cerocca/AirSpark/README.md

# AirSpark
Spark core powered Weather & Air Monitoring Device

Weather sensors:
- DHT22
- BMP180
- RJ sockets for external rain and wind meters

Air quality sensors:
- MICS-4514
- TGS-2xxx socket (fits TGS-2600, TGS-2602, etc)
- MQ-x socket (fits MQ-3, MQ-5, etc)
