cerocca/AirSpark/AirSpark_0.9-BOM.xls

Qty | Value | Device | Parts | Description | Comments | SMD/TH | Pins n° | Tot pins | Supplier | Supplier P/N | Manufacturer | Manufacturer P/N | Cost 1 (€) | Cost 100 (€)
 | SMD
1 | 100n | C-USC0603 | C1 | MLCC SMD capacitor, X7R, 100NF +/- 10% , 25V | min order qty. 10 pcs | SMD | 2 | 2 | farnell | 1759037 (http://it.farnell.com/multicomp/mc0603b104k250ct/condensatore-mlcc-x7r-100nf-25v/dp/1759037) | Multicomp | MC0603B104K250CT (http://it.farnell.com/multicomp/mc0603b104k250ct/condensatore-mlcc-x7r-100nf-25v/dp/1759037) | 0.0073 | 0.062
1 | 10uF | C-USC0603 | C2 | MLCC SMD capacitor, X5R, 10uF +/- 10%, 10V | min order qty. 10 pcs | SMD | 2 | 2 | farnell | 2211164 (http://it.farnell.com/tdk/c1608x5r1a106k080ac/condensatore-mlcc-x5r-10uf-10v/dp/2211164) | TDK | C1608X5R1A106K080AC (http://it.farnell.com/tdk/c1608x5r1a106k080ac/condensatore-mlcc-x5r-10uf-10v/dp/2211164) | 0.24 | 0.133
 |  |  |  |  | alternative part |  |  |  |  | 1288201 (http://it.farnell.com/kemet/c0603c106m9pactu/condensatore-mlcc-x5r-10uf-6-3v/dp/1288201) |  | C0603C106M9PACTU (http://it.farnell.com/kemet/c0603c106m9pactu/condensatore-mlcc-x5r-10uf-6-3v/dp/1288201)
7 | 1k | R-US_R0603 | R1, R5 .. R10 | Thick film SMD resistor, 1K, 0.5%, 50V, 100mW | min order qty. 10 pcs | SMD | 2 | 14 | farnell | 2379938 (http://it.farnell.com/panasonic-electronic-components/erj3rbd1001v/res-thick-film-1k-0-5-50v-0603/dp/2379938) | Panasonic | ERJ3RBD1001V (http://it.farnell.com/panasonic-electronic-components/erj3rbd1001v/res-thick-film-1k-0-5-50v-0603/dp/2379938) | 0.032 | 0.039
 |  |  |  |  | alternative part |  |  |  |  | 2303145 (http://it.farnell.com/panasonic-electronic-components/erj3ekf1001v/res-thick-film-1k-100mw-1-0603/dp/2303145) |  | ERJ3EKF1001V (http://it.farnell.com/panasonic-electronic-components/erj3ekf1001v/res-thick-film-1k-100mw-1-0603/dp/2303145)
5 | 10k | R-US_R0603 | R2, R13, R14, R16, R18 | Thick film SMD resistor, 10K, 0.5%, 50V, 100mW | min order qty. 10 pcs - R14 biases TGS-2600 | SMD | 2 | 10 | farnell | 2303192 (http://it.farnell.com/panasonic-electronic-components/erj3ekf1002v/res-thick-film-10k-100mw-1-0603/dp/2303192) | Panasonic | ERJ3EKF1002V (http://it.farnell.com/panasonic-electronic-components/erj3ekf1002v/res-thick-film-10k-100mw-1-0603/dp/2303192) | 0.008 | 0.0074
2 | 4.7k | R-US_R0603 | R3, R4 | Thick film SMD resistor, 4.7K, 0.5%, 50V, 100mW | min order qty. 10 pcs | SMD | 2 | 4 | farnell | 2303181 (http://it.farnell.com/panasonic-electronic-components/erj3ekf4701v/res-thick-film-4k7-100mw-1-0603/dp/2303181) | Panasonic | ERJ3EKF4701V (http://it.farnell.com/panasonic-electronic-components/erj3ekf4701v/res-thick-film-4k7-100mw-1-0603/dp/2303181) | 0.011 | 0.008
1 | 1M | R-US_R0603 | R11 | Thick film SMD resistor, 1M, 0.5%, 50V, 100mW | min order qty. 10 pcs - biases MQ sensor | SMD | 2 | 2 | farnell | 2303325 (http://it.farnell.com/panasonic-electronic-components/erj3ekf1004v/res-thick-film-1m-100mw-1-0603/dp/2303325) | Panasonic | ERJ3EKF1004V (http://it.farnell.com/panasonic-electronic-components/erj3ekf1004v/res-thick-film-1m-100mw-1-0603/dp/2303325) | 0.009 | 0.0079
3 | 100R | R-US_R0603 | R12, R15, R17 | Thick film SMD resistor, 100R, 0.5%, 50V, 100mW | min order qty. 10 pcs | SMD | 2 | 6 | farnell | 2303059 (http://it.farnell.com/panasonic-electronic-components/erj3ekf1000v/res-thick-film-100r-100mw-1-0603/dp/2303059) | Panasonic | ERJ3EKF1000V (http://it.farnell.com/panasonic-electronic-components/erj3ekf1000v/res-thick-film-100r-100mw-1-0603/dp/2303059) | 0.008 | 0.0074
2 | 82R | R-US_R0603 | R19, R22 | Thick film SMD resistor, 82R, 0.5%, 50V, 100mW | min order qty. 10 pcs | SMD | 2 | 4 | farnell | 2303052 (http://it.farnell.com/panasonic-electronic-components/erj3ekf82r0v/res-thick-film-82r-100mw-1-0603/dp/2303052) | Panasonic | ERJ3EKF82R0V (http://it.farnell.com/panasonic-electronic-components/erj3ekf82r0v/res-thick-film-82r-100mw-1-0603/dp/2303052) | 0.008 | 0.0057
1 | 51R | R-US_R0603 | R20 | Thick film SMD resistor, 51R, 0.5%, 50V, 100mW | min order qty. 10 pcs | SMD | 2 | 2 | farnell | 2059275 (http://it.farnell.com/panasonic-electronic-components/erj3ekf51r0v/resistore-0603-51r-1-0-1w/dp/2059275) | Panasonic | ERJ3EKF51R0V (http://it.farnell.com/panasonic-electronic-components/erj3ekf51r0v/resistore-0603-51r-1-0-1w/dp/2059275) | 0.009 | 0.008
1 | 1.4k | R-US_R0603 | R21 | Thick film SMD resistor, 1.4K, 0.5%, 50V, 100mW | min order qty. 10 pcs - biases MICS-4514 | SMD | 2 | 2 | farnell | 2311968 (http://it.farnell.com/panasonic-electronic-components/erjp03f1401v/resistore-pell-spessa-1-4kohm/dp/2311968) | Panasonic | ERJP03F1401V (http://it.farnell.com/panasonic-electronic-components/erjp03f1401v/resistore-pell-spessa-1-4kohm/dp/2311968) | 0.0871 | 0.0618
1 | 47k | R-US_R0603 | R23 | Thick film SMD resistor, 47K, 0.5%, 50V, 100mW | min order qty. 10 pcs | SMD | 2 | 2 | farnell | 2303213 (http://it.farnell.com/panasonic-electronic-components/erj3ekf4702v/res-thick-film-47k-100mw-1-0603/dp/2303213) | Panasonic | ERJ3EKF4702V (http://it.farnell.com/panasonic-electronic-components/erj3ekf4702v/res-thick-film-47k-100mw-1-0603/dp/2303213) | 0.009 | 0.0079
6 | BAS16 | DIODE | D1 .. D6 | SOD-323 signal diode | min order qty. 5 pcs | SMD | 2 | 12 | farnell | 1459029 (http://it.farnell.com/on-semiconductor/bas16ht1g/diodo-segnale-75v-sod-323/dp/1459029) | ON Semi | BAS16HT1G (http://it.farnell.com/on-semiconductor/bas16ht1g/diodo-segnale-75v-sod-323/dp/1459029) | 0.169 | 0.058
3 | NMOS BSS138 | N-MOS | Q1, Q2, Q3 | 60 V, 360 mA N-channel Trench MOSFET | min order qty. 5 pcs | SMD | 3 | 9 | farnell | 1859849 (http://it.farnell.com/nxp/bss138p/mosfet-canale-n-60v-0-36a-sot23/dp/1859849) | NXP | BSS138P (http://it.farnell.com/nxp/bss138p/mosfet-canale-n-60v-0-36a-sot23/dp/1859849) | 0.129 | 0.069
1 | MICS-4514 | MICS-4514 | U$6 | CO & NOx sensor | price in USD, needs RFQ x > 100 pcs | SMD | 10 | 10 | cdiweb | MICS-4514 (http://www.cdiweb.com/ProductDetail/MICS4514-e2v/333417/) | SGX Sensortech Ltd. | MICS-4514 (http://www.cdiweb.com/ProductDetail/MICS4514-e2v/333417/) | 9.72 | 6.2
 | TH_2_SOLDER
1 | 5V PWR | LED3MM | LED1 | LED | can be omitted | TH | 2 | 2 | farnell | N/A | various | N/A | 0.1 | 0.1
1 | 0.5M | TRIM_US-B25P | POT1 | 1/4 ” Square 3 pole Trimming Potentiometer | flat angled - biases MQ sensor | TH | 3 | 3 | farnell | 9354395 (http://it.farnell.com/bourns/3362p-1-504lf/taglierina-500k/dp/9354395) | BOURNS | 3362P-1-504LF (http://it.farnell.com/bourns/3362p-1-504lf/taglierina-500k/dp/9354395) | 0.816 | 0.583
1 | 5k | TRIM_US-B25P | POT2 | 1/4 ” Square 3 pole Trimming Potentiometer | flat angled - biases TGS-2600 | TH | 3 | 3 | farnell | 9354379 (http://it.farnell.com/bourns/3362p-1-502lf/trimmer-5k/dp/9354379) | BOURNS | 3362P-1-502LF (http://it.farnell.com/bourns/3362p-1-502lf/trimmer-5k/dp/9354379) | 0.996 | 0.596
1 | CALIBRATION | TAC_SWITCHPTH | S1 | Momentary Switch | calibration push button | TH | 4 | 4 | various | N/A | various | N/A | 0.1 | 0.1
2 | SPARK_CORECORE | SPARK_CORECORE | U$1 | Spark Core microcontroller sockets | 2x12 pin female sockets | TH | 12 | 24 | farnell | 1593465 (http://it.farnell.com/multicomp/2212s-12sg-85/socket-pcb-1-fila-12-vie/dp/1593465) | Multicomp | 2212S-12SG-85 (http://it.farnell.com/multicomp/2212s-12sg-85/socket-pcb-1-fila-12-vie/dp/1593465) | 0.121 | 0.112
1 | BMP_BRK | BMP_BRK | U$2 | BMP180 sensor breakout socket | can be omitted - 1x5 pin female socket | TH | 5 | 5 | farnell | 1593461 (http://it.farnell.com/multicomp/2212s-05sg-85/socket-pcb-1-fila-5-vie/dp/1593461) | Multicomp | 2212S-05SG-85 (http://it.farnell.com/multicomp/2212s-05sg-85/socket-pcb-1-fila-5-vie/dp/1593461) | 0.674 | 0.538
1 | DHT22 | DHT22 | U$3 | DHT22 sensor | Humidity & Temperature sensor | TH | 4 | 4 | ebay | DHT22 / AM2302 | various | DHT22 / AM2302 | 5 | 4
1 | MQ_SENSOR_SOCKET | MQ_SENSOR_SOCKET | U$4 | MQ sensor socket | any 6 pin MQ sensor should fit | TH | 7 | 7 | various | N/A | N/A | N/A | 1 | 0.5
1 | TGS_SENSOR_SOCKET | TGS_SENSOR_SOCKET | U$5 | TGS sensor socket | TGS-2xxx sensors should fit | TH | 4 | 4 | Figaro | SR-6 | Figaro | SR-6 | 3.7 | 3
3 | I2C, ADC, UART | TWIG-4P-2.0-2.0 | J1, J2,J3 | GROVE style male 4 pin PCB connector | price in USD, min order qty. 10 pcs | TH | 4 | 12 | seeedstudio | SKU: ACC39145O | N/A | N/A | 0.9 | 0.9
1 | USB-SMD-NS | USB-SMD-NS | X1 | Mini-B USB connector | used for power only (5V) | TH | 11 | 11 | farnell | 1654060 (http://it.farnell.com/te-connectivity-amp/1734035-1/connettore-mini-usb-b-contatto/dp/1654060) | TE conn./ AMP | 1734035-1. (http://it.farnell.com/te-connectivity-amp/1734035-1/connettore-mini-usb-b-contatto/dp/1654060) | 1.2 | 0.904
1 | VIN_SCREW | 1751248 | X2 | 3,5 mm 2 poles screw connector | used for external 5v power | TH | 2 | 2 | farnell | 1098611 (http://it.farnell.com/te-connectivity/1776275-2/terminal-block-wire-to-brd-2pos/dp/1098611) | TE conn./ AMP | 1776275-2 (http://it.farnell.com/te-connectivity/1776275-2/terminal-block-wire-to-brd-2pos/dp/1098611) | 0.236 | 0.161
2 | RJ11-WIND, RJ11-RAIN | RJ11-6PTH | X3, X4 | RJ11 Socket | RJ11 Sockets for U&5A sensors | TH | 6 | 12 | farnell | 2076092 (http://it.farnell.com/molex/95009-7661/socket-fcc-68-6-vie-6-contatti/dp/2076092) | Molex | 95009-7661 (http://it.farnell.com/molex/95009-7661/socket-fcc-68-6-vie-6-contatti/dp/2076092) | 0.736 | 0.453
 | TH_2_INSERT
1 | SPARK_CORECORE | SPARK_CORECORE | U$1A | Spark Core microcontroller | price in USD, 1 = core, 2 = photon | TH | 12 | - | spark.io | N/A | spark.io | CORE / PHOTON | 39 | 19
1 | BMP_BRK | BMP_BRK | U$2A | BMP180 sensor breakout board | Pressure & Temperature sensor breakout | TH | 5 | - | ebay (owayl) | N/A | N/A |  | 4.5 | 4.5
1 | MQ-3 | Air Sensor | U$3A | Alcohol Gas Sensor, fit with U$3A | fits in U$3, price in USD x seeedstudio | TH | 4 | - | various | MQ-3 | various | MQ-3 | 3.95 | 2
1 | TGS-2600 | TGS_SENSOR | U$4A | Air Contaminants sensor | fits with U$4A | TH | 4 | - | various | TGS-2600 | Figaro | TGS-2600 | 11 | 6
1 | RAIN&WIND | Rain & Wind sensors | U$5A | Weather Sensor Assembly | plugs in X3 & X4 | N/A | N/A | - | sparkfun | SEN-08942 | Argent Data Systems | p/n 80422 | 64.51 | 51.61
 | " | " | " | alternative supply | plugs in X3 & X4 | N/A | N/A | - | watterott | SEN-08942 | Argent Data Systems | p/n 80422 | 74.32 | 74.32
 | TH_2_INSERT
? | N/A | DIODE | N/A | Diode, ZENER, 0.5W, 3.3V, DO-35 (http://it.farnell.com/multicomp/1n746a/diodo-zener-0-5w-3-3v-do-35/dp/1861479) | Protection diode for Analog IN channels | TH | 2 | 2 | farnell | 1861479 (http://it.farnell.com/multicomp/1n746a/diodo-zener-0-5w-3-3v-do-35/dp/1861479) | Multicomp | 1N746A | 0.0118 | 0.0118
 |  |  |  |  | To be soldered below the PCB, where needed
 | NOTES:
 | Prices are net of shipping
 | Prices italic and underlined are only reference prices
