cerocca/AirSpark/AirSpark_0.9-SCHEMATIC.pdf

1

2

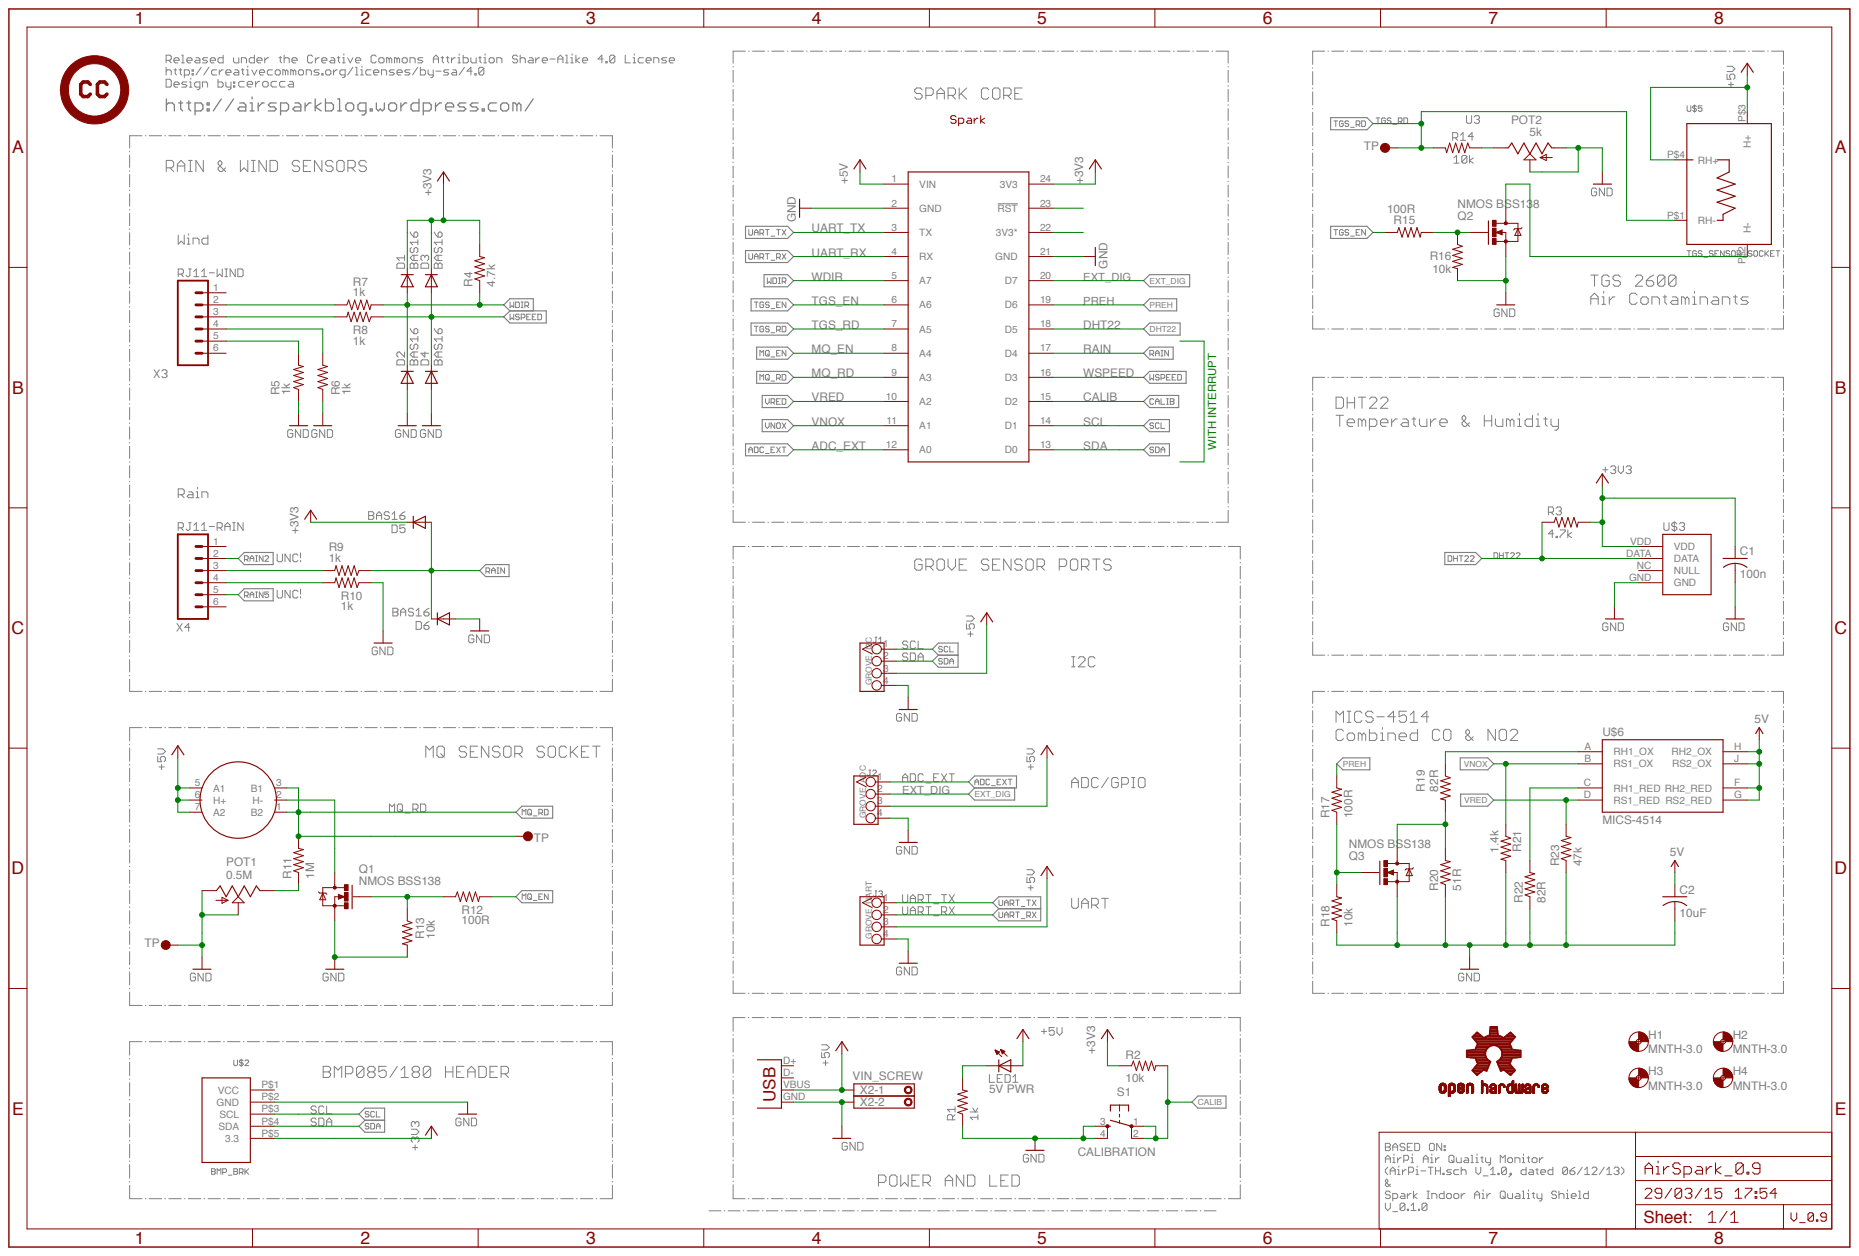
[picture p1: page 1]
