cerocca/AirSpark/EAGLE/AirSpark_0.9.brd

## EAGLE design EAGLE/AirSpark_0.9.brd (2015-03-29)

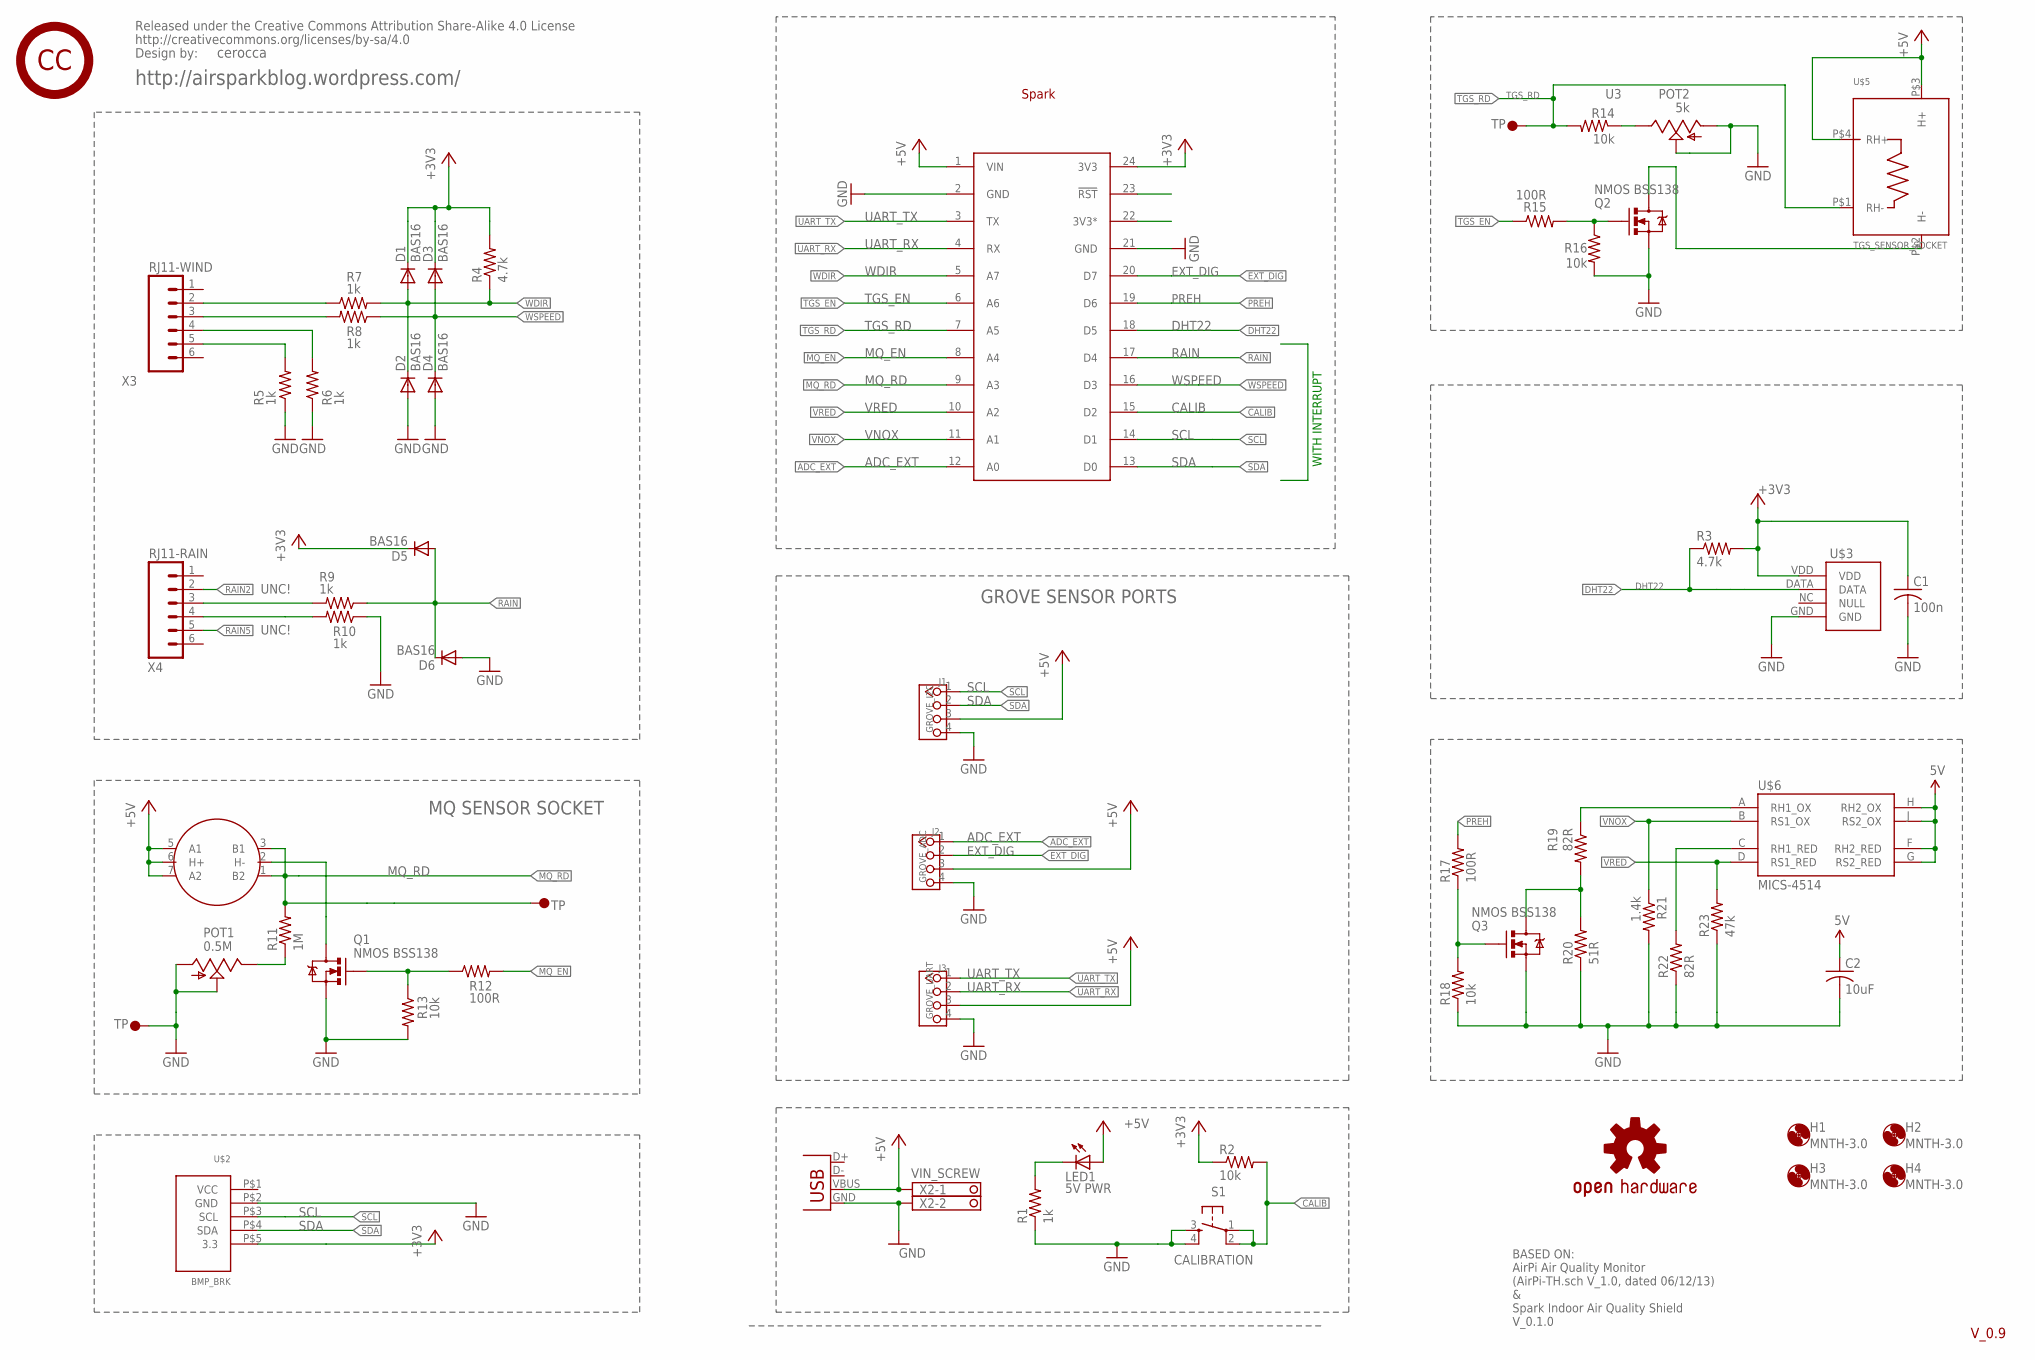
[picture p2: schematic AirSpark_0.9.sch]

Parts:
C1: 100n; C0603
C2: 10uF; C0603
D1, D2, D3, D4, D5, D6: BAS16; SOD-323
H1, H2, H3, H4: MNTH-3.0; 3,0
J1: GROVE_I2C; 4P-2.0
J2: GROVE_ADC; 4P-2.0
J3: GROVE_UART; 4P-2.0
LED1: 5V PWR; LED3MM
LOGO101: OSHW-LOGOL; OSHW-LOGO-L
POT1: 0.5M; B25P
POT2: 5k; B25P
Q1, Q2, Q3: NMOS BSS138; SOT23-3
R1, R5, R6, R7, R8, R9, R10: 1k; R0603
R2, R13, R14, R16, R18: 10k; R0603
R3, R4: 4.7k; R0603
R11: 1M; R0603
R12, R15, R17: 100R; R0603
R19, R22: 82R; R0603
R20: 51R; R0603
R21: 1.4k; R0603
R23: 47k; R0603
S1: CALIBRATION; TACTILE-PTH
U$1: SPARK_CORECORE; SPARK_CORE
U$2: BMP_BRK
U$3: DHT22
U$4: MQ_SENSOR_SOCKET
U$5: TGS_SENSOR_SOCKET; SR6
U$6: MICS-4514; MICS_10-SMD
U$7: MQ_TP; TESTPAD-PTR
U$8: TGS_TP; TESTPAD-PTR
U$9: GND_TP; TESTPAD-PTR
U$101: CC
U$102: CREATIVE_COMMONS
U$103: SPARK_LOGO..; SPARK_LOGO
X1: USB-SMD-NS; USB-MINIB-NOSTOP
X2: VIN_SCREW; 1751248
X3: RJ11-WIND; RJ11-6
X4: RJ11-RAIN; RJ11-6

Connections:
+3V3: C1.1, D1.1 (C), D3.1 (C), D5.1 (C), R2.1, R3.2, R4.2, U$1.24 (3V3), U$2.P$5 (3.3), U$3.VDD
+5V: C2.1, J1.3, J2.3, J3.3, LED1.A, U$1.1 (VIN), U$4.5 (A1), U$4.6 (H+), U$4.7 (A2), U$5.P$3 (H+), U$5.P$4 (RH+), U$6.F (RH2_RED), U$6.G (RS2_RED), U$6.H (RH2_OX), U$6.J (RS2_OX), X1.VBUS, X2.1
ADC_EXT: J2.1, U$1.12 (A0)
CALIB: R2.2, S1.1, S1.2, U$1.15 (D2)
DHT22: R3.1, U$1.18 (D5), U$3.DATA
EXT_DIG: J2.2, U$1.20 (D7)
GND: C1.2, C2.2, D2.2 (A), D4.2 (A), D6.2 (A), J1.4, J2.4, J3.4, POT1.A, POT1.S, POT2.A, POT2.S, Q1.2 (S), Q2.2 (S), Q3.2 (S), R1.1, R5.1, R6.1, R10.1, R13.2, R16.2, R18.1, R20.1, R21.2, R22.1, R23.1, S1.3, S1.4, U$1.2 (GND), U$1.21 (GND), U$2.P$2 (GND), U$3.GND, U$9.TP, X1.GND, X2.2
MQ_EN: R12.2, U$1.8 (A4)
MQ_RD: R11.2, U$1.9 (A3), U$4.1 (B2), U$4.3 (B1), U$7.TP
unnamed: R19.1, U$6.A (RH1_OX)
unnamed: POT2.E, R14.1
unnamed: Q3.1 (G), R17.1, R18.2
unnamed: R22.2, U$6.C (RH1_RED)
unnamed: Q3.3 (D), R19.2, R20.2
unnamed: Q1.3 (D), U$4.2 (H-)
unnamed: Q2.3 (D), U$5.P$2 (H-)
unnamed: Q1.1 (G), R12.1, R13.1
unnamed: LED1.K (C), R1.2
unnamed: Q2.1 (G), R15.2, R16.1
unnamed: POT1.E, R11.1
unnamed: R7.1, X3.2
unnamed: R8.2, X3.3
unnamed: R9.2, X4.3
unnamed: R10.2, X4.4
unnamed: R5.2, X3.5
unnamed: R6.2, X3.4
PREH: R17.2, U$1.19 (D6)
RAIN: D5.2 (A), D6.1 (C), R9.1, U$1.17 (D4)
RAIN2: X4.2
RAIN5: X4.5
SCL: J1.1, U$1.14 (D1), U$2.P$3 (SCL)
SDA: J1.2, U$1.13 (D0), U$2.P$4 (SDA)
TGS_EN: R15.1, U$1.6 (A6)
TGS_RD: R14.2, U$1.7 (A5), U$5.P$1 (RH-), U$8.TP
UART_RX: J3.2, U$1.4 (RX)
UART_TX: J3.1, U$1.3 (TX)
VNOX: R21.1, U$1.11 (A1), U$6.B (RS1_OX)
VRED: R23.2, U$1.10 (A2), U$6.D (RS1_RED)
WDIR: D1.2 (A), D2.1 (C), R4.1, R7.2, U$1.5 (A7)
WSPEED: D3.2 (A), D4.1 (C), R8.1, U$1.16 (D3)

Notes on the sheet:
BASED ON: AirPi Air Quality Monitor (AirPi-TH.sch V_1.0, dated 06/12/13) & Spark Indoor Air Quality Shield V_0.1.0
U$3
GROVE SENSOR PORTS
MQ SENSOR SOCKET
UNC!
WITH INTERRUPT
http://airsparkblog.wordpress.com/
cerocca
V_0.9

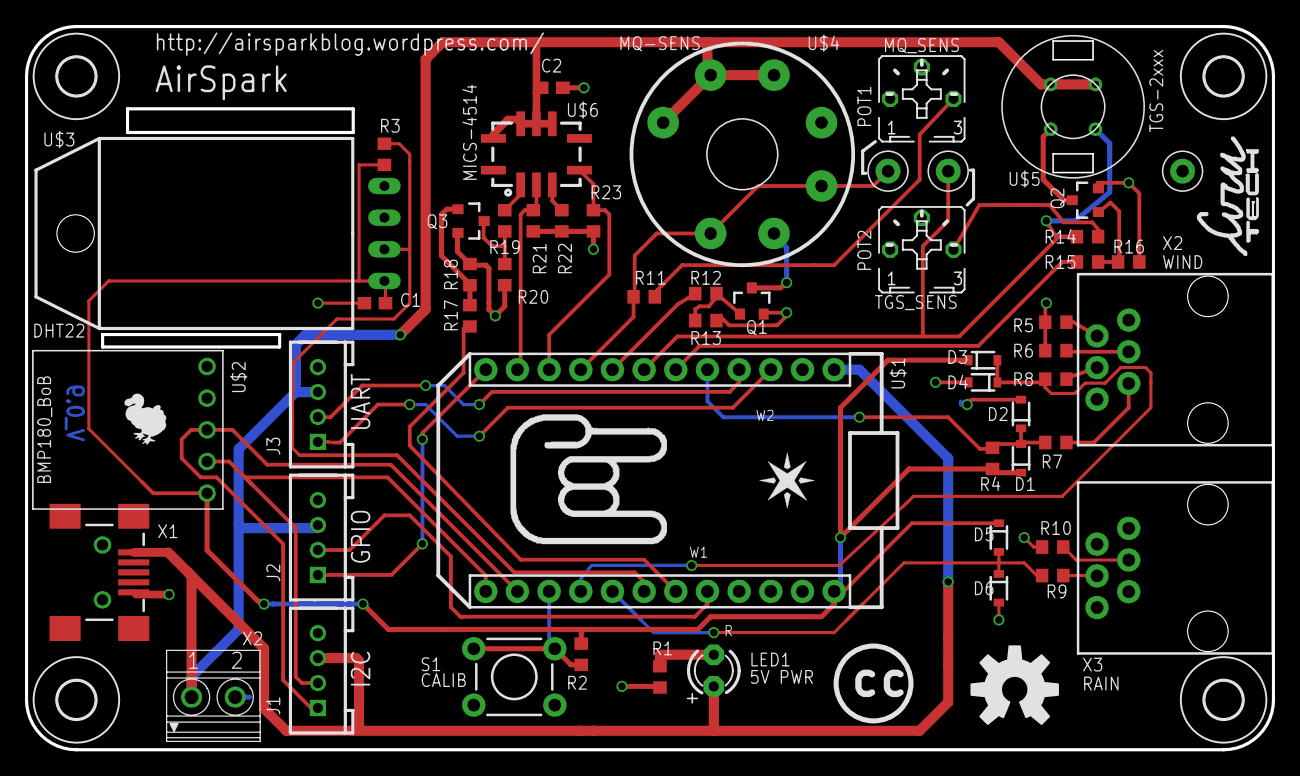
[picture p3: board AirSpark_0.9.brd from above]

Board: 2 copper layers, 100.0 x 58.0 mm, 65 parts (0 on the bottom side), 38 nets.

Other parts of the board:
U$12: DOD
U$104: CIRU_1X05
U$105: ROCKIT
