cerocca/AirSpark/(notices)

Notices in the files:
parts and their libraries:
AirSpark: Released under the Creative Commons Attribution Share-Alike 4.0 License
AirSpark: http://creativecommons.org/licenses/by-sa/4.0
